tobsec/Lager_CAN_BedienPanel/README.md

Lager_CAN_BedienPanel
=====================

3teiliges Bedienpanel
