tobsec/Lager_CAN_BedienPanel/hardware/kicad/Controlpanel/shapes3D/c-282856-3-d1-3d.stp

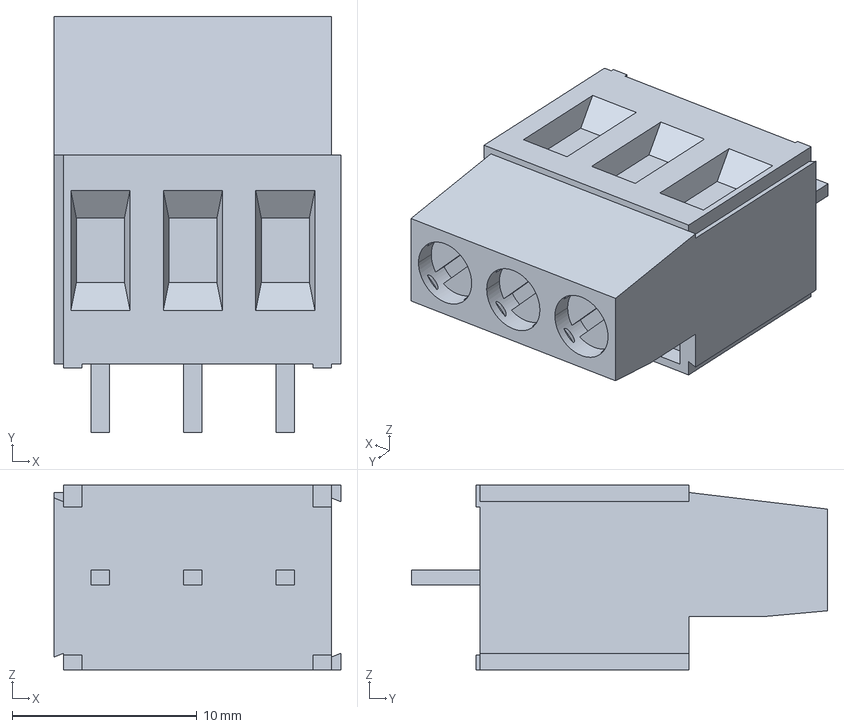
[picture p1: CAD file, 2025-01-28]
hardware/kicad/Controlpanel/shapes3D/c-282856-3-d1-3d.stp
15.5 x 22.5 x 10.0 mm
