tobsec/Lager_CAN_BedienPanel/hardware/kicad/Controlpanel/shapes3D/c-282856-2-d1-3d.stp

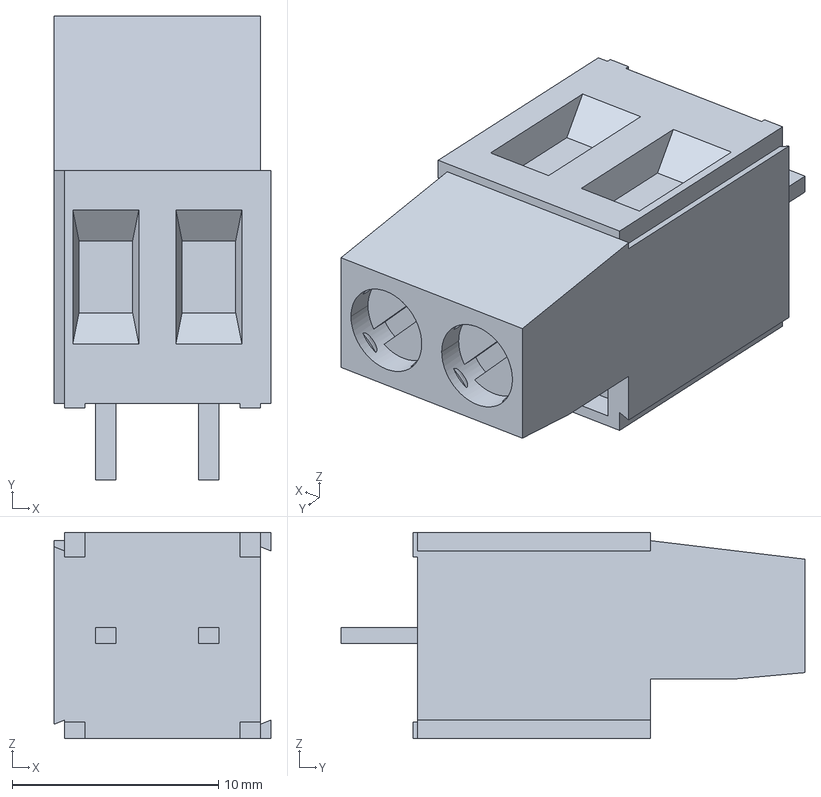
[picture p2: CAD file, 2025-01-28]
hardware/kicad/Controlpanel/shapes3D/c-282856-2-d1-3d.stp
10.5 x 22.5 x 10.0 mm
