tobsec/Lager_CAN_BedienPanel/hardware/kicad/Controlpanel/Controlpanel.kicad_pcb

## KiCad design hardware/kicad/Controlpanel/Controlpanel.kicad_pcb (2025-01-28)

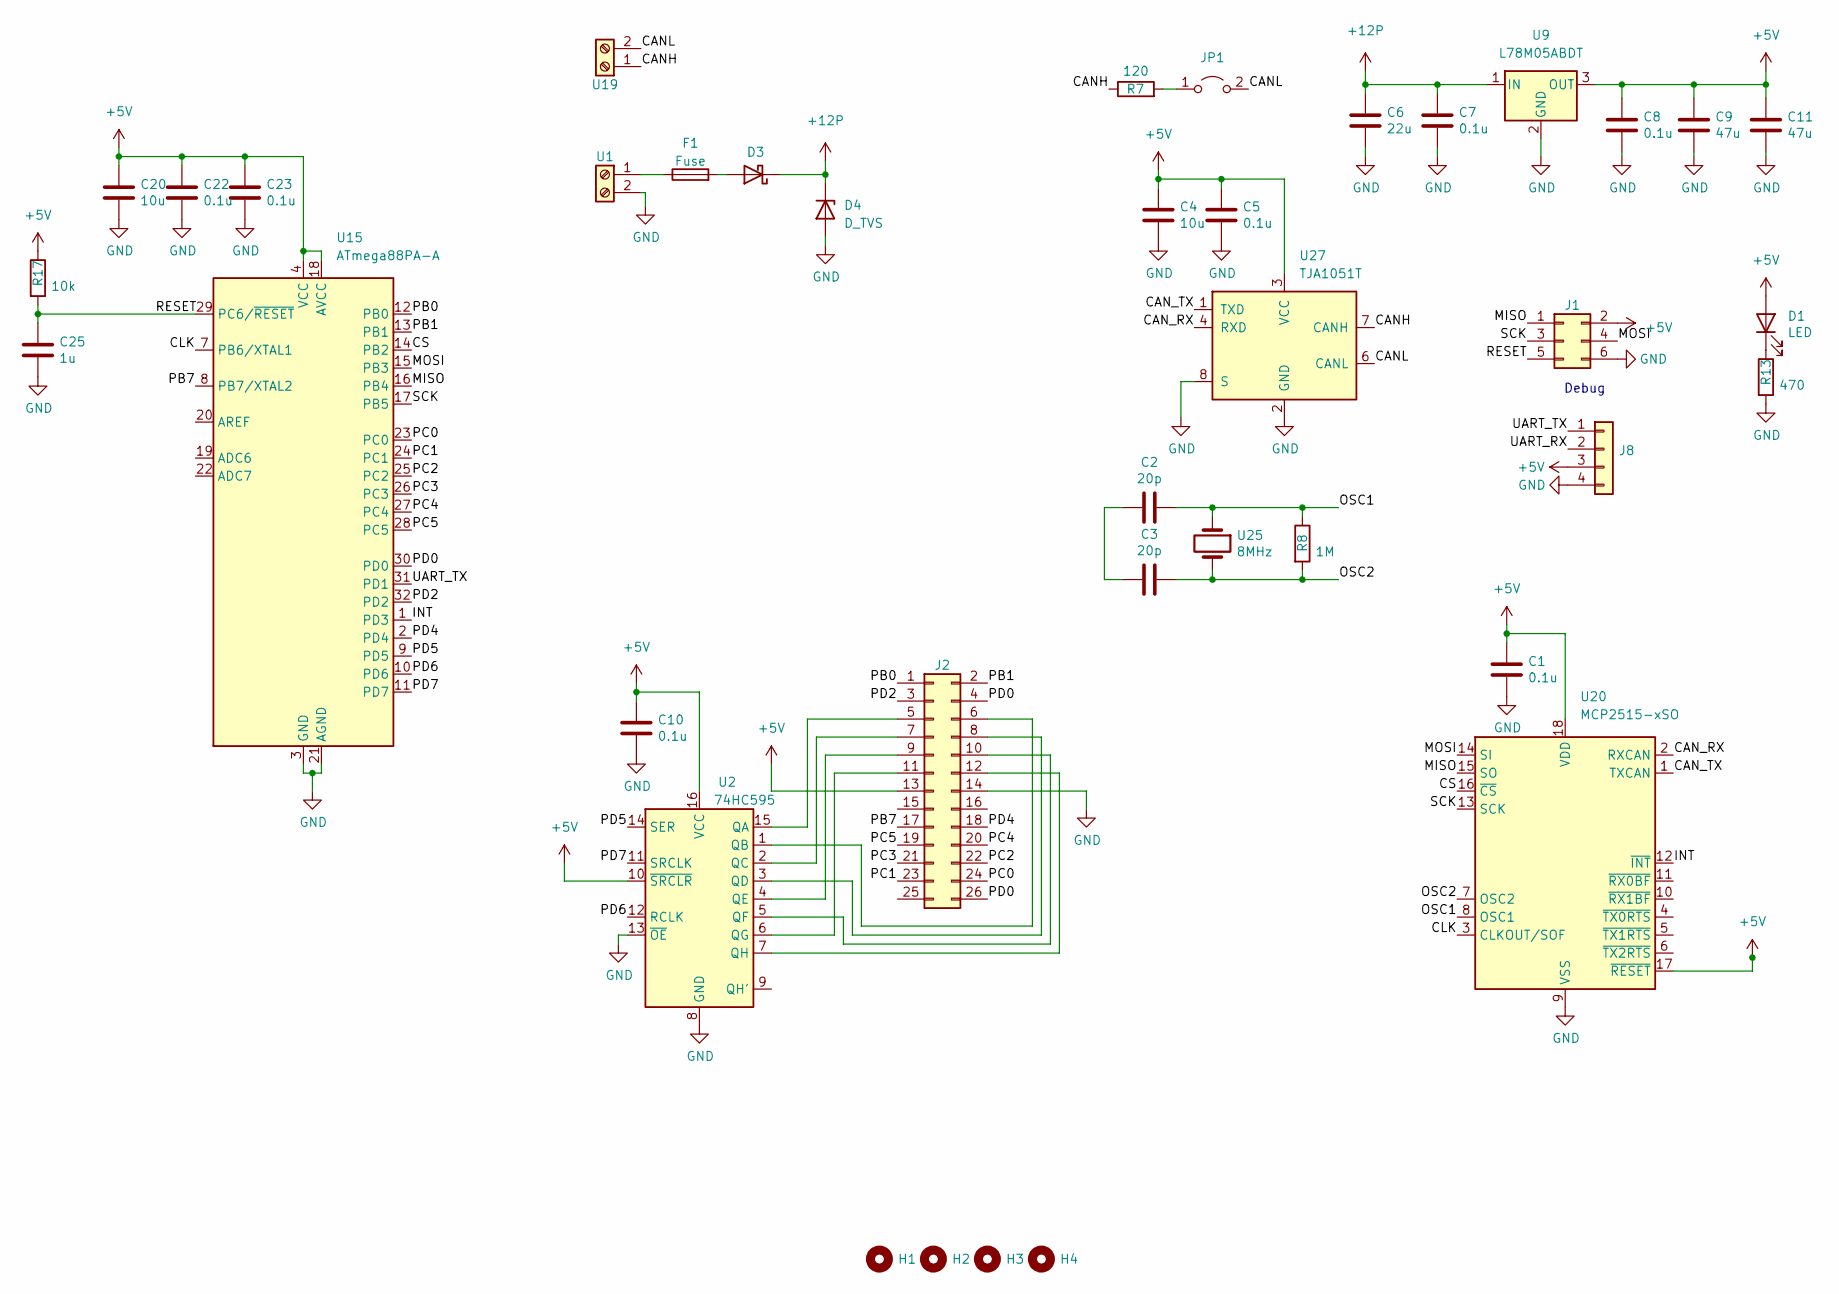
[picture p3: schematic Controlpanel.kicad_sch]

Parts:
C1, C5, C7, C8, C10, C22, C23: 0.1u; C_0805_2012Metric; MPN C49678
C2, C3: 20p; C_0805_2012Metric; MPN C1798
C4, C20: 10u; C_0805_2012Metric; MPN C15850
C6: 22u; C_1206_3216Metric; MPN C12891
C9, C11: 47u; C_1206_3216Metric; MPN C96123
C25: 1u; C_0805_2012Metric; MPN C28323
D1: LED; LED_0603_1608Metric; MPN C2286
D3: 738-5052; D_SMA; MPN C14996
D4: D_TVS; D_SMA; MPN C19077535
F1: Fuse; Fuse_1812_4532Metric
H1, H2, H3, H4: MountingHole; MountingHole_4.3mm_M4
J1: Conn_02x03_Odd_Even; PinHeader_2x03_P2.54mm_Vertical
J2: Conn_02x03_Odd_Even; PinHeader_2x13_P2.54mm_Vertical
J8: Conn_01x04; PinHeader_1x04_P2.54mm_Vertical
JP1: Jumper_2_Open; PinHeader_1x02_P2.54mm_Vertical
R7: 120; R_0805_2012Metric; MPN C17437
R8: 1M; R_0805_2012Metric; MPN C17514
R13: 470; R_0805_2012Metric; MPN C17710
R17: 10k; R_0805_2012Metric
U1, U19: Screw_Terminal_01x02; TerminalBlock_Altech_AK300-2_P5.00mm
U2: 74HC595; SO-16_3.9x9.9mm_P1.27mm
U9: L78M05ABDT; TO-252-2; MPN C58069
U15: ATmega88PA-A; TQFP-32_7x7mm_P0.8mm; MPN C16190
U20: MCP2515-xSO; SOIC-18W_7.5x11.6mm_P1.27mm; MPN C12368
U25: 8MHz; Crystal_HC49-U_Vertical
U27: TJA1051T; SOIC-8_3.9x4.9mm_P1.27mm; MPN C6952

Connections:
+5V: C1.1, C4.2, C5.1, C8.1, C9.2, C10.1, C11.2, C20.2, C22.1, C23.1, D1.2 (A), J1.2, J2.13, J8.3, R17.1, U2.10 (~SRCLR), U2.16 (VCC), U9.3 (OUT), U15.4 (VCC), U15.6 (VCC), U15.18 (AVCC), U20.17 (~RESET), U20.18 (VDD), U27.3 (VCC)
+12P: C6.2, C7.1, D3.1 (K), D4.1 (K), U9.1 (IN)
/CANH: R7.1, U19.1, U27.7 (CANH)
/CANL: JP1.2 (B), U19.2, U27.6 (CANL)
/CAN_RX: U20.2 (RXCAN), U27.4 (RXD)
/CAN_TX: U20.1 (TXCAN), U27.1 (TXD)
/CLK: U15.7 (PB6/XTAL1), U20.3 (CLKOUT/SOF)
/CS: U15.14 (PB2), U20.16 (~CS)
/INT: U15.1 (PD3), U20.12 (~INT)
/MISO: J1.1, U15.16 (PB4), U20.15 (SO)
/MOSI: J1.4, U15.15 (PB3), U20.14 (SI)
/OSC1: C2.1, R8.1, U20.8 (OSC1), U25.1
/OSC2: C3.1, R8.2, U20.7 (OSC2), U25.2
/PB0: J2.1, U15.12 (PB0)
/PB1: J2.2, U15.13 (PB1)
/PB7: J2.17, U15.8 (PB7/XTAL2)
/PC0: J2.24, U15.23 (PC0)
/PC1: J2.23, U15.24 (PC1)
/PC2: J2.22, U15.25 (PC2)
/PC3: J2.21, U15.26 (PC3)
/PC4: J2.20, U15.27 (PC4)
/PC5: J2.19, U15.28 (PC5)
/PD0: J2.4, J2.26, U15.30 (PD0)
/PD2: J2.3, U15.32 (PD2)
/PD4: J2.18, U15.2 (PD4)
/PD5: U2.14 (SER), U15.9 (PD5)
/PD6: U2.12 (RCLK), U15.10 (PD6)
/PD7: U2.11 (SRCLK), U15.11 (PD7)
/RESET: C25.1, J1.5, R17.2, U15.29 (PC6/~RESET)
/SCK: J1.3, U15.17 (PB5), U20.13 (SCK)
/UART_RX: J8.2
/UART_TX: J8.1, U15.31 (PD1)
GND: C1.2, C4.1, C5.2, C6.1, C7.2, C8.2, C9.1, C10.2, C11.1, C20.1, C22.2, C23.2, C25.2, D4.2 (A), J1.6, J2.14, J8.4, R13.2, U1.2, U2.8 (GND), U2.13 (~OE), U9.2 (GND), U15.3 (GND), U15.5 (GND), U15.21 (AGND), U20.9 (VSS), U27.2 (GND), U27.8 (S)
unnamed: C2.2, C3.2
unnamed: D1.1 (K), R13.1
unnamed: D3.2 (A), F1.2
unnamed: J2.5, U2.15 (QA)
unnamed: J2.6, U2.1 (QB)
unnamed: J2.7, U2.2 (QC)
unnamed: J2.8, U2.3 (QD)
unnamed: J2.9, U2.4 (QE)
unnamed: J2.10, U2.5 (QF)
unnamed: J2.11, U2.6 (QG)
unnamed: J2.12, U2.7 (QH)
unnamed: JP1.1 (A), R7.2
unnamed: F1.1, U1.1

Notes on the sheet:
Debug

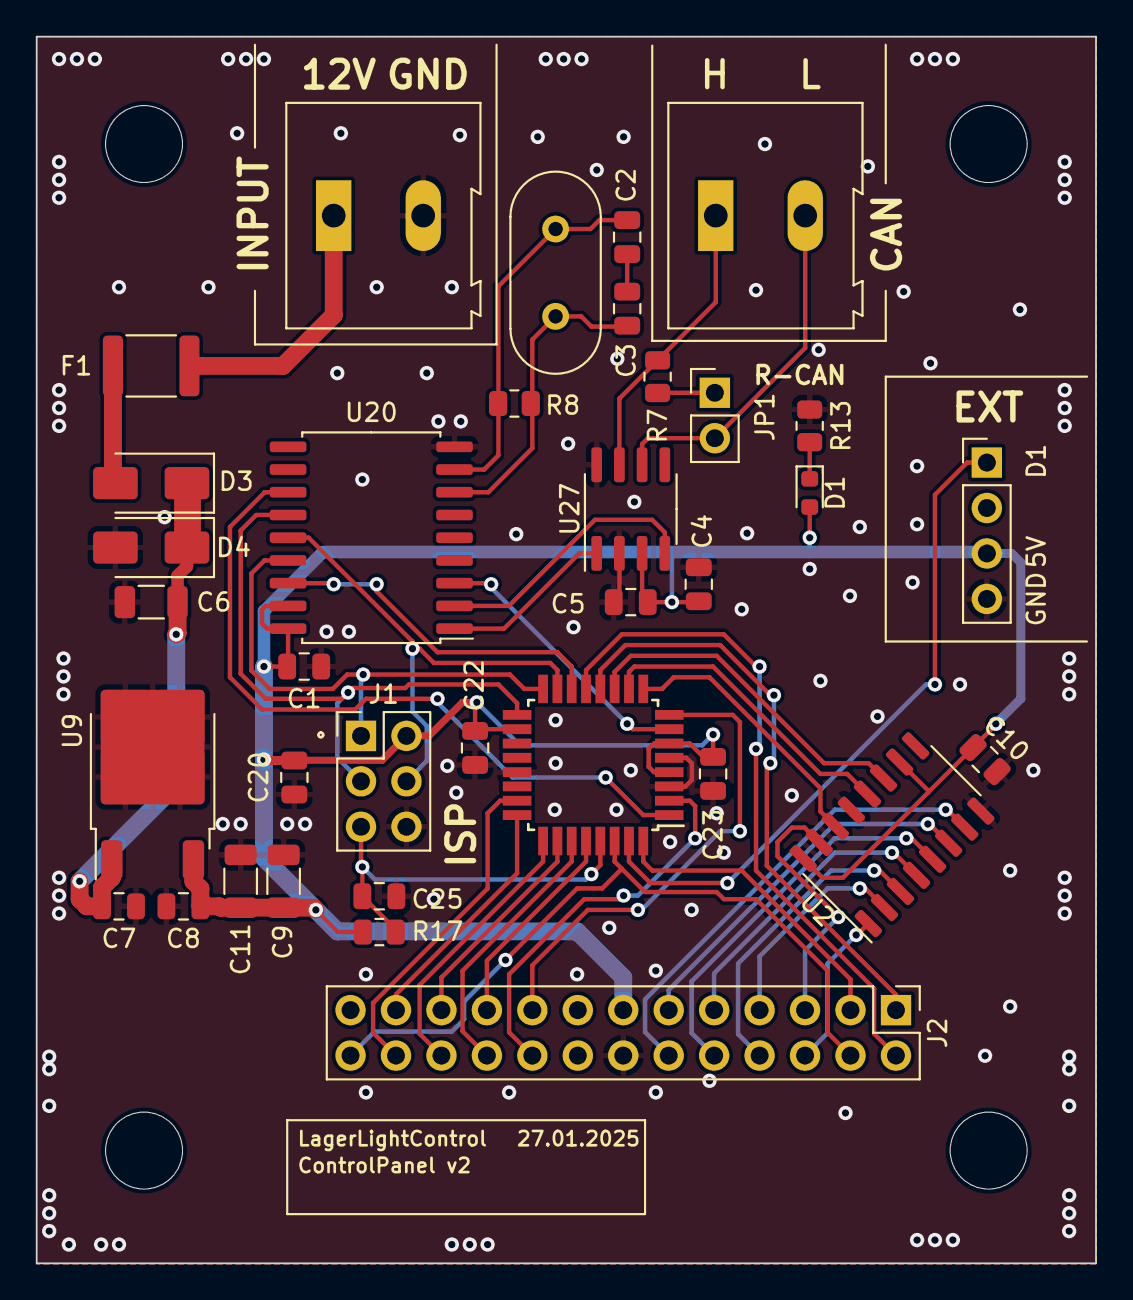
[picture p4: board Controlpanel.kicad_pcb from above]

Board: 2 copper layers, 59.2 x 68.5 mm, 39 parts (0 on the bottom side), 45 nets.
