tobsec/Lager_CAN_BedienPanel/hardware/ATmega8A_Panel/Panel/untitled.brd

## EAGLE design hardware/ATmega8A_Panel/Panel/untitled.brd (2025-01-28)

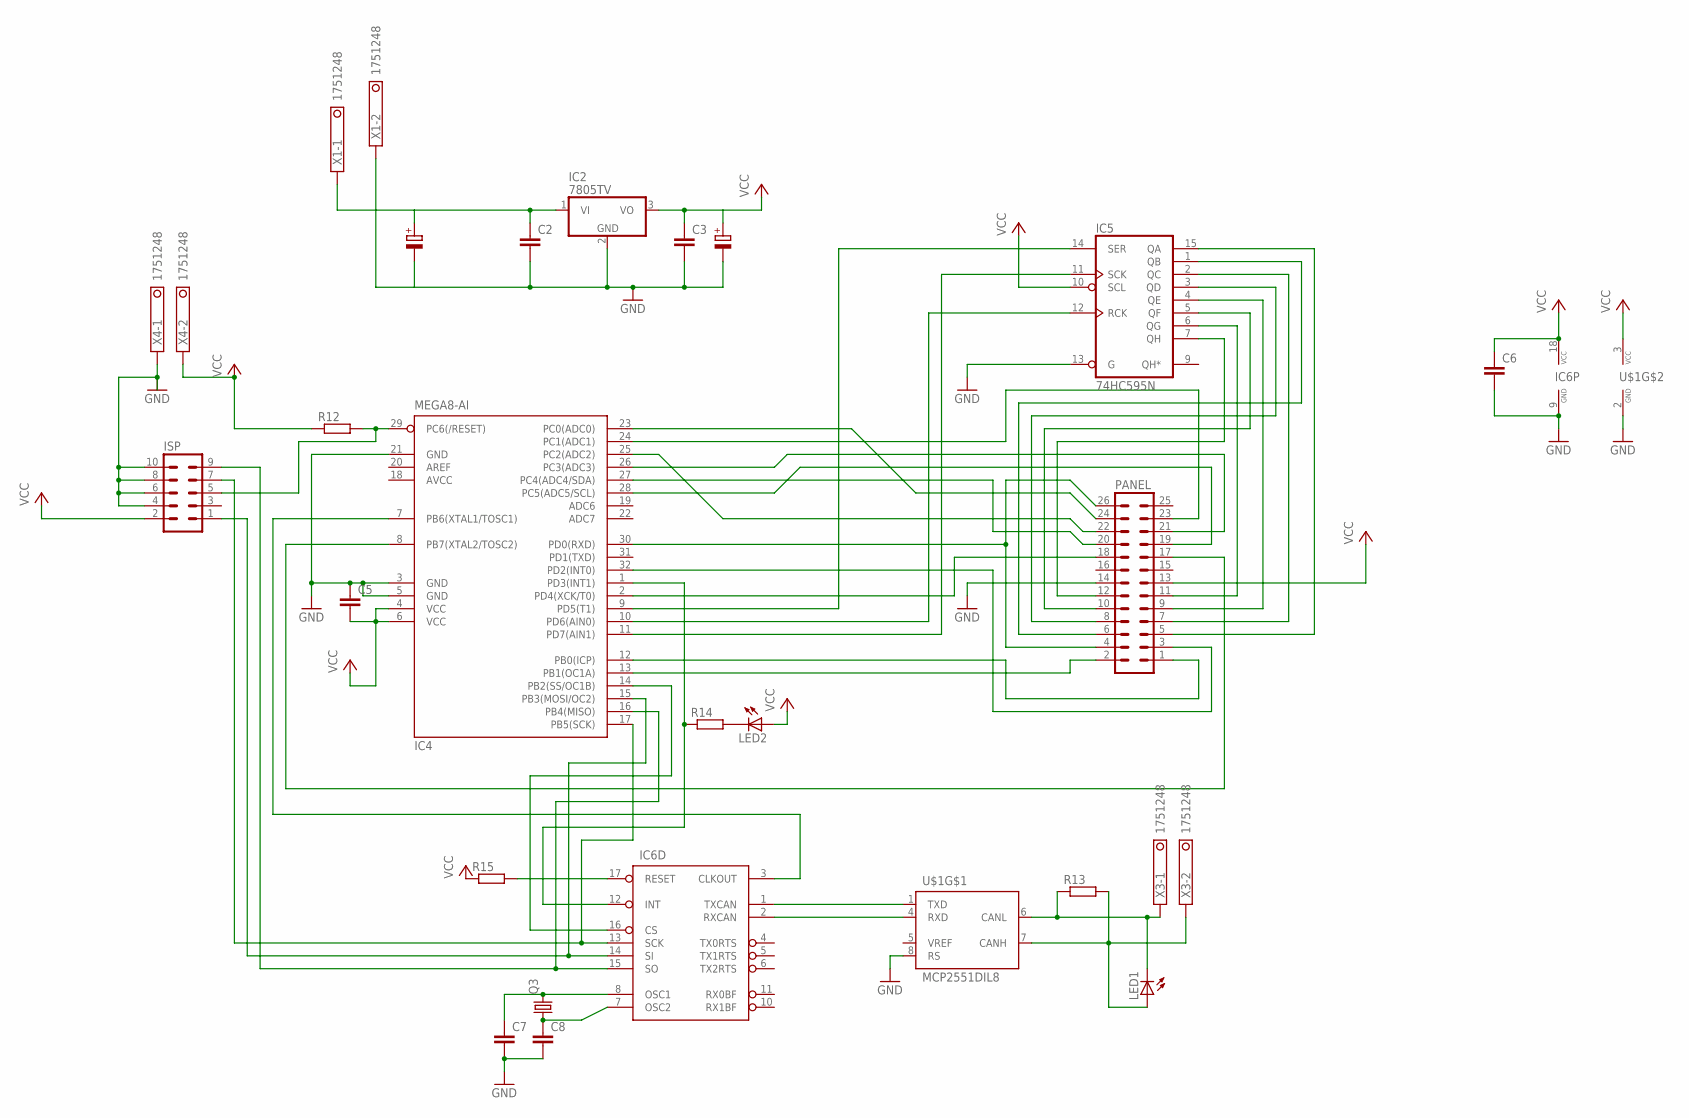
[picture p5: schematic untitled.sch]

Parts:
C2, C3, C5, C6, C7, C8: C2.5/2; C2.5-2
IC2: 7805TV; TO220V
IC4: MEGA8-AI; TQFP32-08
IC5: 74HC595N; DIL16
IC6: MCP2515P; DIL18
ISP: ML10
LED1, LED2: LED3MM
PANEL: ML26
Q3: CRYSTALHC49U-V; HC49U-V
R12, R13, R14, R15: R-EU_0207/10; 0207/10
U$1: MCP2551DIL8; DIL08
X1, X3, X4: 1751248

Connections:
AVCC: IC4.18 (AVCC)
GND: C2.2, C3.2, C5.1, C6.2, C7.2, C8.2, IC2.2 (GND), IC4.3 (GND), IC4.5 (GND), IC4.21 (GND), IC5.8 (GND), IC5.13 (G), IC6.9 (GND), ISP.4, ISP.6, ISP.8, ISP.10, PANEL.14, U$1.2 (GND), U$1.8 (RS), X1.2, X4.1
unnamed: LED1.K (C), R13.1, U$1.6 (CANL), X3.1
unnamed: IC4.29 (PC6(/RESET)), ISP.5, R12.2
unnamed: IC4.12 (PB0(ICP)), PANEL.1
unnamed: C2.1, IC2.1 (VI), X1.1
unnamed: IC4.13 (PB1(OC1A)), PANEL.2
unnamed: IC4.32 (PD2(INT0)), PANEL.3
unnamed: IC4.30 (PD0(RXD)), PANEL.4, PANEL.26
unnamed: IC5.15 (QA), PANEL.5
unnamed: IC5.1 (QB), PANEL.6
unnamed: IC5.2 (QC), PANEL.7
unnamed: IC5.3 (QD), PANEL.8
unnamed: IC5.4 (QE), PANEL.9
unnamed: IC5.5 (QF), PANEL.10
unnamed: IC5.6 (QG), PANEL.11
unnamed: IC5.7 (QH), PANEL.12
unnamed: LED1.A, R13.2, U$1.7 (CANH), X3.2
unnamed: LED2.K (C), R14.2
unnamed: IC4.7 (PB6(XTAL1/TOSC1)), IC6.3 (CLKOUT)
unnamed: IC4.8 (PB7(XTAL2/TOSC2)), PANEL.17
unnamed: IC4.1 (PD3(INT1)), IC6.12 (INT), R14.1
unnamed: IC6.1 (TXCAN), U$1.1 (TXD)
unnamed: IC6.2 (RXCAN), U$1.4 (RXD)
unnamed: C8.1, IC6.7 (OSC2), Q3.1
unnamed: C7.1, IC6.8 (OSC1), Q3.2
unnamed: IC4.23 (PC0(ADC0)), PANEL.24
unnamed: IC4.14 (PB2(SS/OC1B)), IC6.16 (CS)
unnamed: IC6.17 (RESET), R15.2
unnamed: IC4.16 (PB4(MISO)), IC6.15 (SO), ISP.9
unnamed: IC4.15 (PB3(MOSI/OC2)), IC6.14 (SI), ISP.1
unnamed: IC4.17 (PB5(SCK)), IC6.13 (SCK), ISP.7
unnamed: IC4.2 (PD4(XCK/T0)), PANEL.18
unnamed: IC4.28 (PC5(ADC5/SCL)), PANEL.19
unnamed: IC4.27 (PC4(ADC4/SDA)), PANEL.20
unnamed: IC4.26 (PC3(ADC3)), PANEL.21
unnamed: IC4.25 (PC2(ADC2)), PANEL.22
unnamed: IC4.24 (PC1(ADC1)), PANEL.23
unnamed: IC4.11 (PD7(AIN1)), IC5.11 (SCK)
unnamed: IC4.10 (PD6(AIN0)), IC5.12 (RCK)
unnamed: IC4.9 (PD5(T1)), IC5.14 (SER)
VCC: C3.1, C5.2, C6.1, IC2.3 (VO), IC4.4 (VCC), IC4.6 (VCC), IC5.10 (SCL), IC5.16 (VCC), IC6.18 (VCC), ISP.2, LED2.A, PANEL.13, R12.1, R15.1, U$1.3 (VCC), X4.2

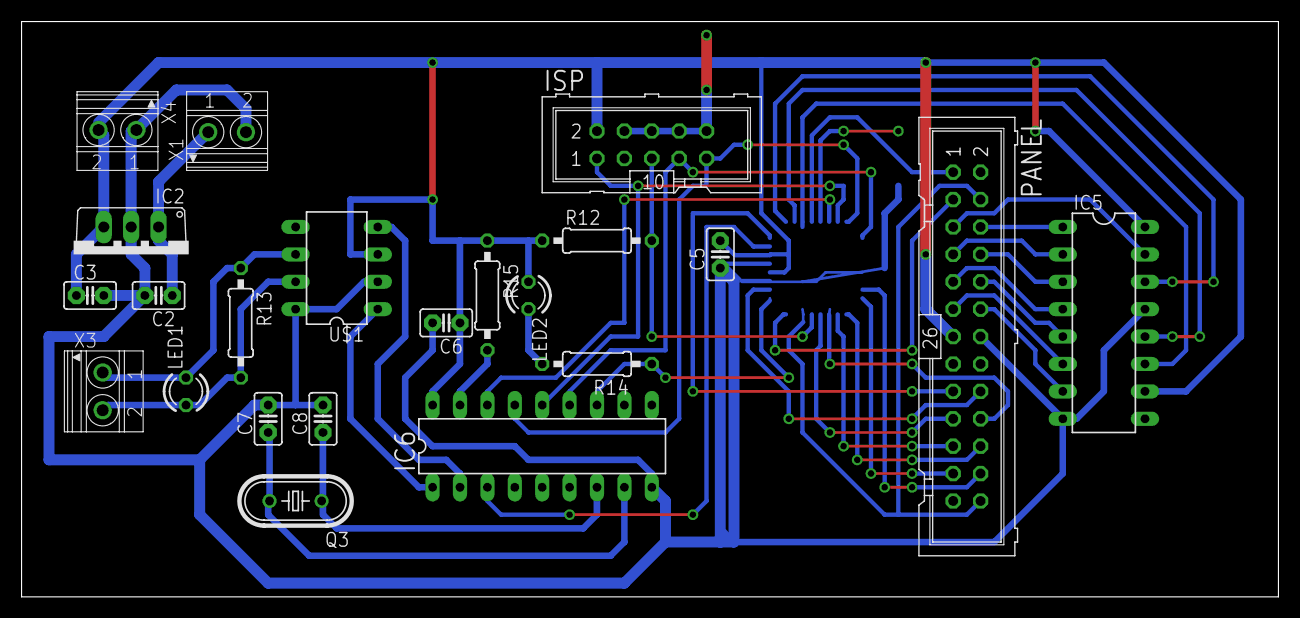
[picture p6: board untitled.brd from above]

Board: 2 copper layers, 116.5 x 53.3 mm, 23 parts (1 on the bottom side), 41 nets.
