tobsec/Lager_CAN_BedienPanel/(commit log)

2014-09-08 Commit des aktuellen Standes
2025-01-28 Add Eeagle PCB (old)
    [untitled.brd, untitled.sch]
2025-01-28 Add KiCad PCB - as ordered
    [Controlpanel.kicad_pcb, Controlpanel.kicad_sch, Controlpanel.sch, bom.csv, c-282856-2-d1-3d.stp, c-282856-3-d1-3d.stp, designators.csv, positions.csv]
2025-01-28 add CAN requested reset for BL, LagerLight protocol V2, prepare CAN flashing
    [ATmega8_MCP2515.c, LagerLight_protocol.h]
2025-02-15 Comments, adapt for the control panel PCB
2026-05-14 firmware: state-machine scene recall to space SET frames ~16 ms apart
    Each scene button used to blast all 5 SET_VALUE frames into the TX FIFO
    in a tight for-loop inside the timer ISR. The frames hit the bus in
    quick succession and the gateway-side RX queue could drop one during a
    slow MQTT TLS publish.
    Replaced the 10 burst sites with a single requestSceneRecall(N) helper
    that records (pendingSceneIdx, pendingSceneChannel). A small drainer in
    main() emits one SET_VALUE per ~16 ms (SCENE_RECALL_GAP_TICKS * ~8 ms
    ISR tick). Whole scene recalls in ~80 ms instead of microseconds — slow
    enough that the bus and the gateway can keep up.
    Boot init also spaced: replaced five back-to-back can_send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
    [ATmega8_MCP2515.c]
2026-05-14 fix(can): bus-off recovery, TX-stall reinit, and ring-buffer overflow guard
    Panel could feel "frozen" under heavy button activity. Root cause was a
    trio of issues in the MCP2515 driver layer:
    - can_sendBufferedMessage re-queued every failed TX forever; once the
    bus went bus-off the MCP2515 stopped ACKing and the firmware
    spin-pushed the same frame back into the FIFO indefinitely.
    - TX ring buffer had no full-check and used a hard-coded wrap at 24
    (TXBUF_LEN is 32). Producer silently overwrote unconsumed slots.
    - RX ring buffer also had no full-check.
    Now: count consecutive can_send_message failures and force can_init()
    after CAN_TX_FAIL_THRESHOLD (50) strikes. Poll EFLG.TXB0 once eve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
    [CAN.c]
2026-05-15 fix(panel): close ISR/main races causing button-freeze under load
    The "feels frozen but scene LEDs still work" failure mode under heavy
    button activity was three concurrent-access bugs between the TIMER0
    ISR (~2 kHz, owns LED multiplex + button polling + WDT kick) and the
    main loop:
    - can_addMessageToTxBuffer was MPSC: ISR (button presses) and main
    (scene-recall drain, REQUEST_VALUE response, can_sendBufferedMessage
    retry) both wrote bufTx_tx without a guard. Read-modify-write could
    interleave so main clobbered an ISR-queued button frame at the same
    slot. Wrap the producer with ATOMIC_BLOCK(ATOMIC_RESTORESTATE).
    - defaultMsgToLightActor11 was a shared global mutated by both
    contex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
    [ATmega8_MCP2515.c, CAN.c]
2026-05-15 fix(panel): conditional WDT kick to self-recover from main-loop hangs
    After the MPSC race fix in 07456b5 the panel still locked up under
    some load. Symptoms: stale display values, no button response, but
    the LED multiplex keeps running — i.e. ISR alive, main hung. The
    existing WDT setup unconditionally kicks from the TIMER0 ISR (which
    is required to protect the LED multiplex from burnout — see the
    ISR comment), so a hung main loop never trips the watchdog.
    Add a main-loop heartbeat counter. Main increments it every iteration.
    The ISR's wdt_reset() only fires when the heartbeat changed between
    checks. If main hangs, the heartbeat stops, the ISR stops kicking,
    and the 250 ms WDT fires to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
    [ATmega8_MCP2515.c]
2026-05-15 fix(spi): bounded busy-wait in spi_putc to prevent SPI-hang lockups
    The original spi_putc had an unbounded `while (!(SPSR & (1<<SPIF))) ;`.
    Every mcp2515_* call goes through this, so any condition that prevents
    SPIF from setting (MCP2515 power glitch, ESD event, controller mode
    lockup, broken physical link) used to hang the MCU indefinitely.
    That's a plausible root cause for the panel's "feels frozen, LED
    multiplex still works" failure mode: ISR keeps running because it
    doesn't touch SPI, but main is wedged inside spi_putc waiting on a
    flag that will never set. Combined with the conditional WDT kick from
    17792de, this is the soft (return-bogus-data) + hard (WDT-reset)
    layered recovery.
    Tim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
    [MCP2515.c]
